CoastRunnerCNC/coastrunner_cr1_pcbs/cr1_led_board/README.md

# CR1 LED Strip
LED PCB for CR-1. Also contains mount for probe wire plug.

PCB designed in KiCAD.
