CoastRunnerCNC/coastrunner_cr1_pcbs/cr1_uno_shield/README.md

# Coast Runner Uno Shield
Uno Shield for CR-1: closed loop spindle VFD + 4 stepper drivers
Main Controller PCB for CR-1.  Hardware version 3B

This is the first PCB shipped in CR-1.

PCB designed in KiCAD.
