CoastRunnerCNC/coastrunner_cr1_pcbs/cr1_led_board/PCB/LEDIO.kicad_pcb

## KiCad design cr1_led_board/PCB/LEDIO.kicad_pcb (2024-05-17)

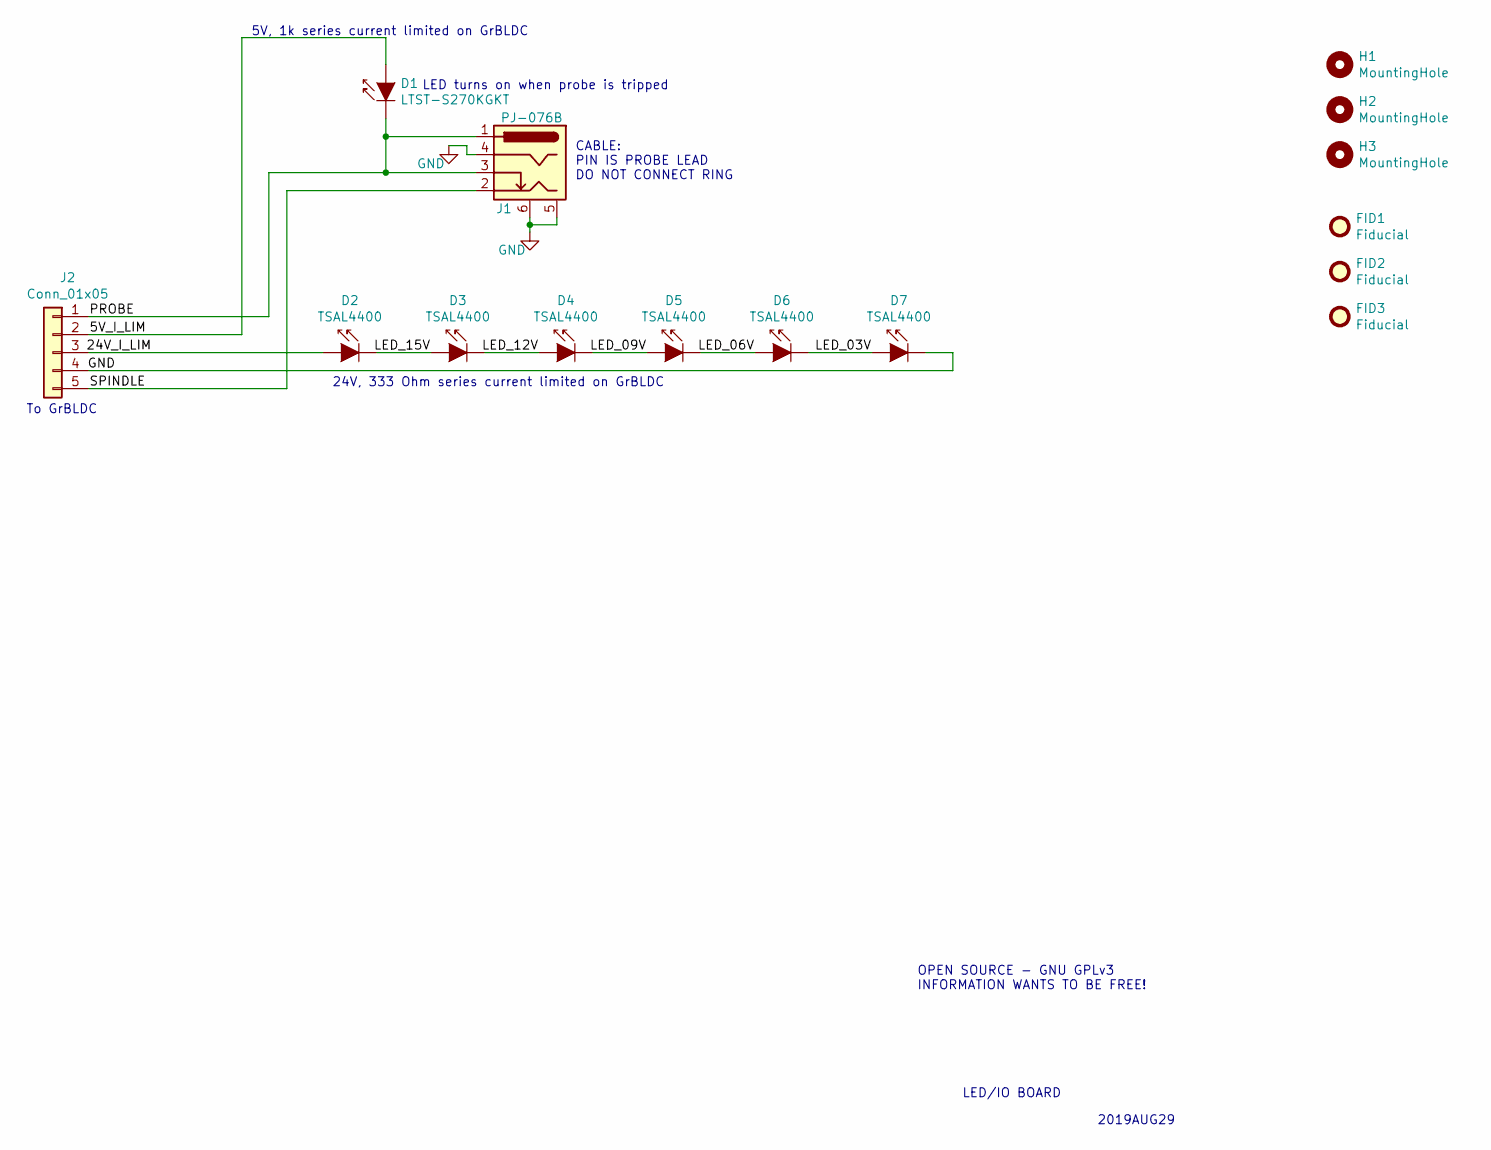
[picture p1: schematic LEDIO.sch]

Parts:
D1: LTST-S270KGKT; D_0603_1608Metric
D2, D3, D4, D5, D6, D7: TSAL4400; D_1206_3216Metric
FID1, FID2, FID3: Fiducial; Fiducial_0.5mm_Mask1mm
H1, H2, H3: MountingHole; MountingHole_3.2mm_M3
J1: PJ-076B; CUI_PJ-076
J2: Conn_01x05; PinHeader_1x05_P2.54mm_Horizontal

Connections:
/5V_I_LIM: D1.2 (A), J2.2
/24V_I_LIM: D2.2 (A), J2.3
/LED_03V: D6.1 (K), D7.2 (A)
/LED_06V: D5.1 (K), D6.2 (A)
/LED_09V: D4.1 (K), D5.2 (A)
/LED_12V: D3.1 (K), D4.2 (A)
/LED_15V: D2.1 (K), D3.2 (A)
/PROBE: D1.1 (K), J1.1, J1.3, J2.1
/SPINDLE: J1.2, J2.5
GND: D7.1 (K), J1.4, J1.5 (ShieldA), J1.6 (ShieldB), J2.4

Notes on the sheet:
CABLE: PIN IS PROBE LEAD DO NOT CONNECT RING
2019AUG29
LED/IO BOARD
OPEN SOURCE - GNU GPLv3 INFORMATION WANTS TO BE FREE!
5V, 1k series current limited on GrBLDC
To GrBLDC
LED turns on when probe is tripped
24V, 333 Ohm series current limited on GrBLDC

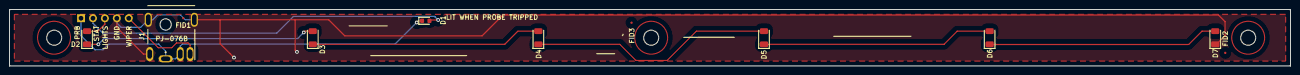
[picture p2: board LEDIO.kicad_pcb from above]

Board: 2 copper layers, 272.5 x 12.0 mm, 15 parts (1 on the bottom side), 10 nets.
