CoastRunnerCNC/coastrunner_cr1_pcbs/cr1_uno_shield/PCB (KiCAD)/GrBLDC.kicad_pcb

## KiCad design cr1_uno_shield/PCB (KiCAD)/GrBLDC.kicad_pcb (2024-05-17)

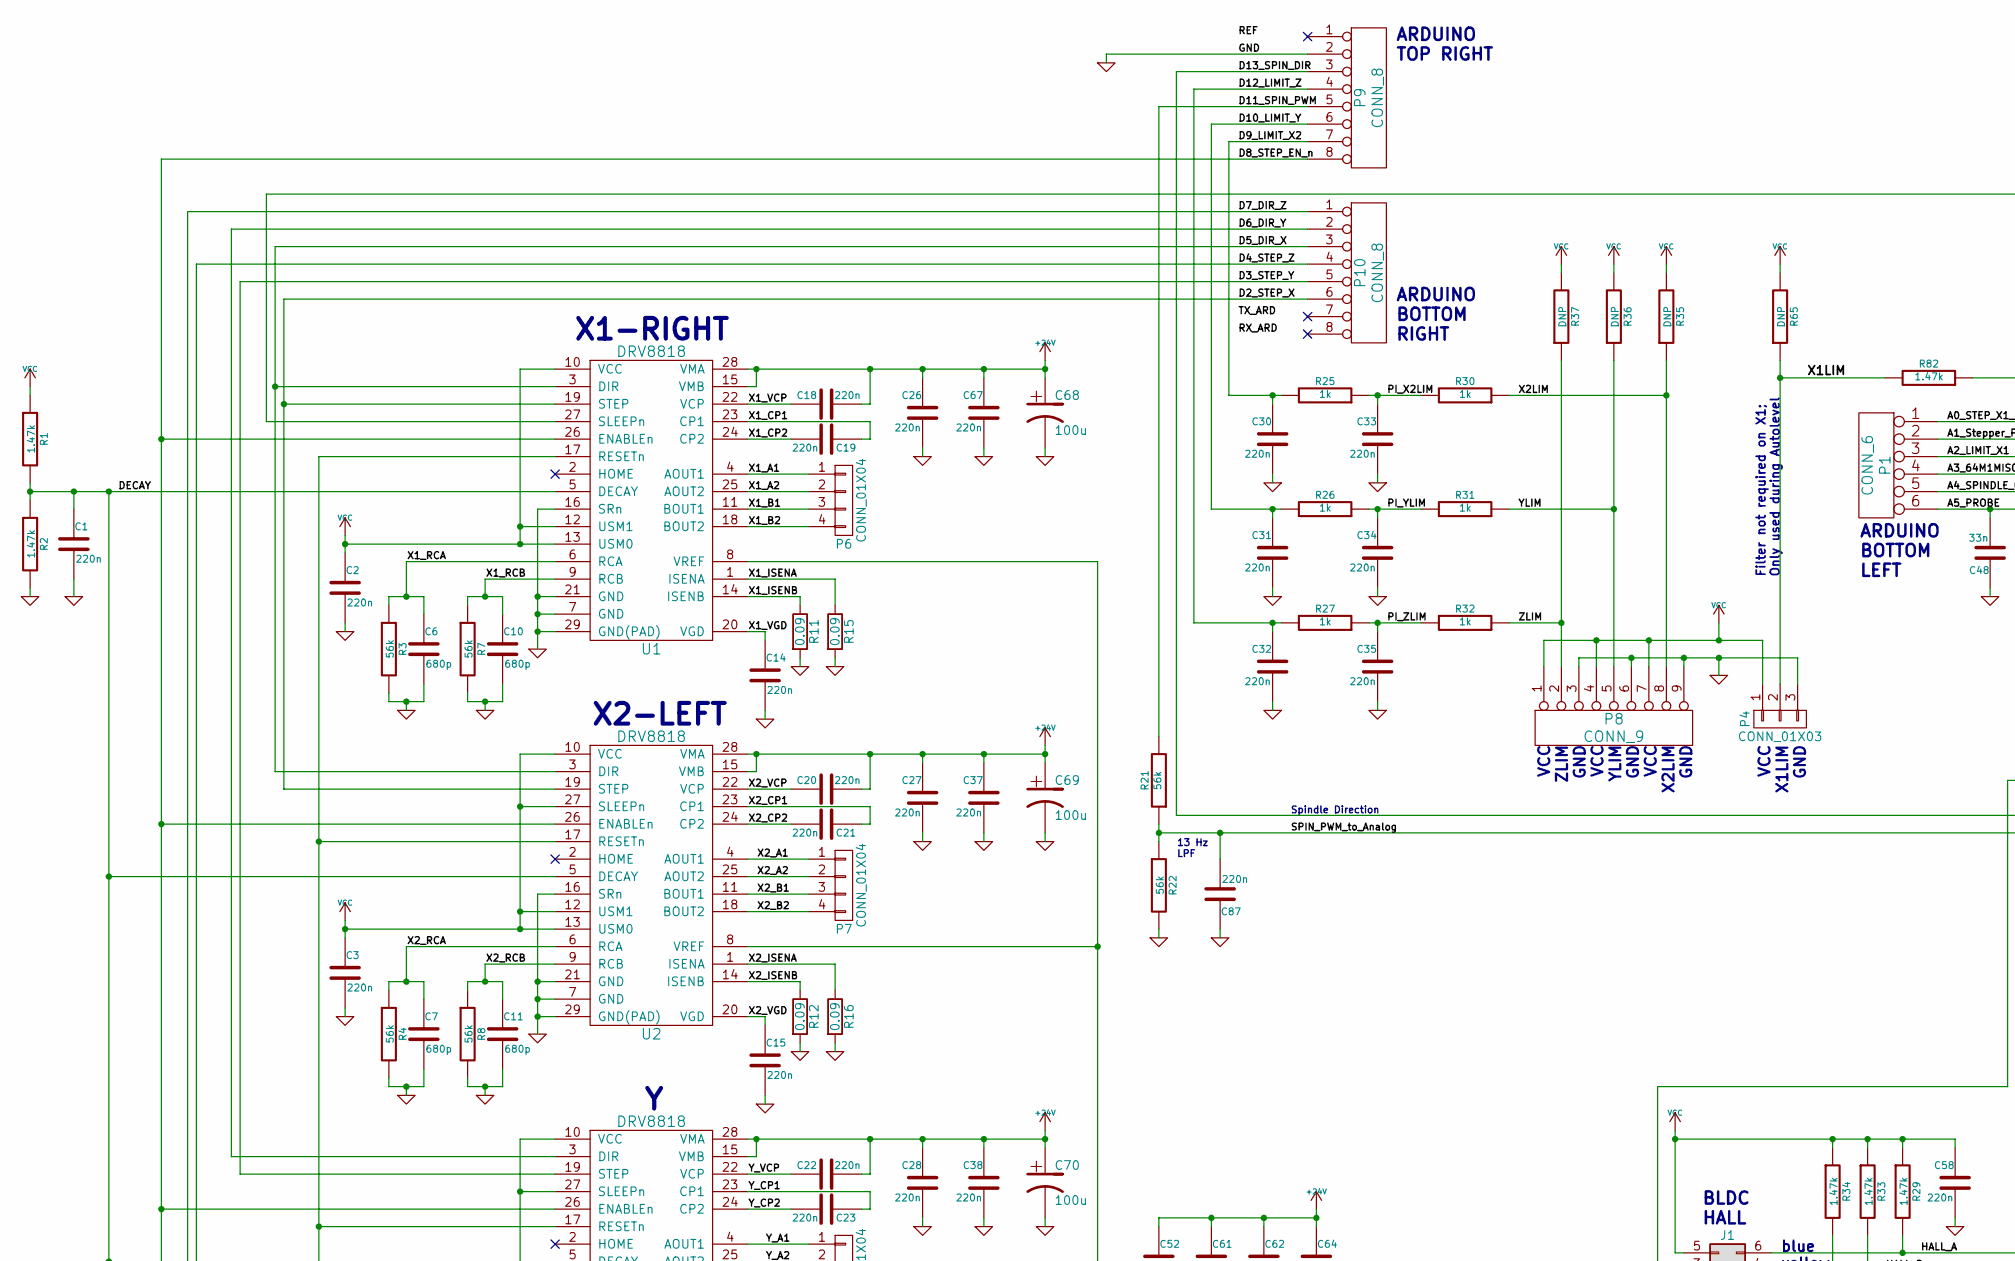
[picture p3: schematic GrBLDC.sch, GrBLDCv3 - CNC Stepper & BLDC Arduino Shield, part in row 1, column 1]

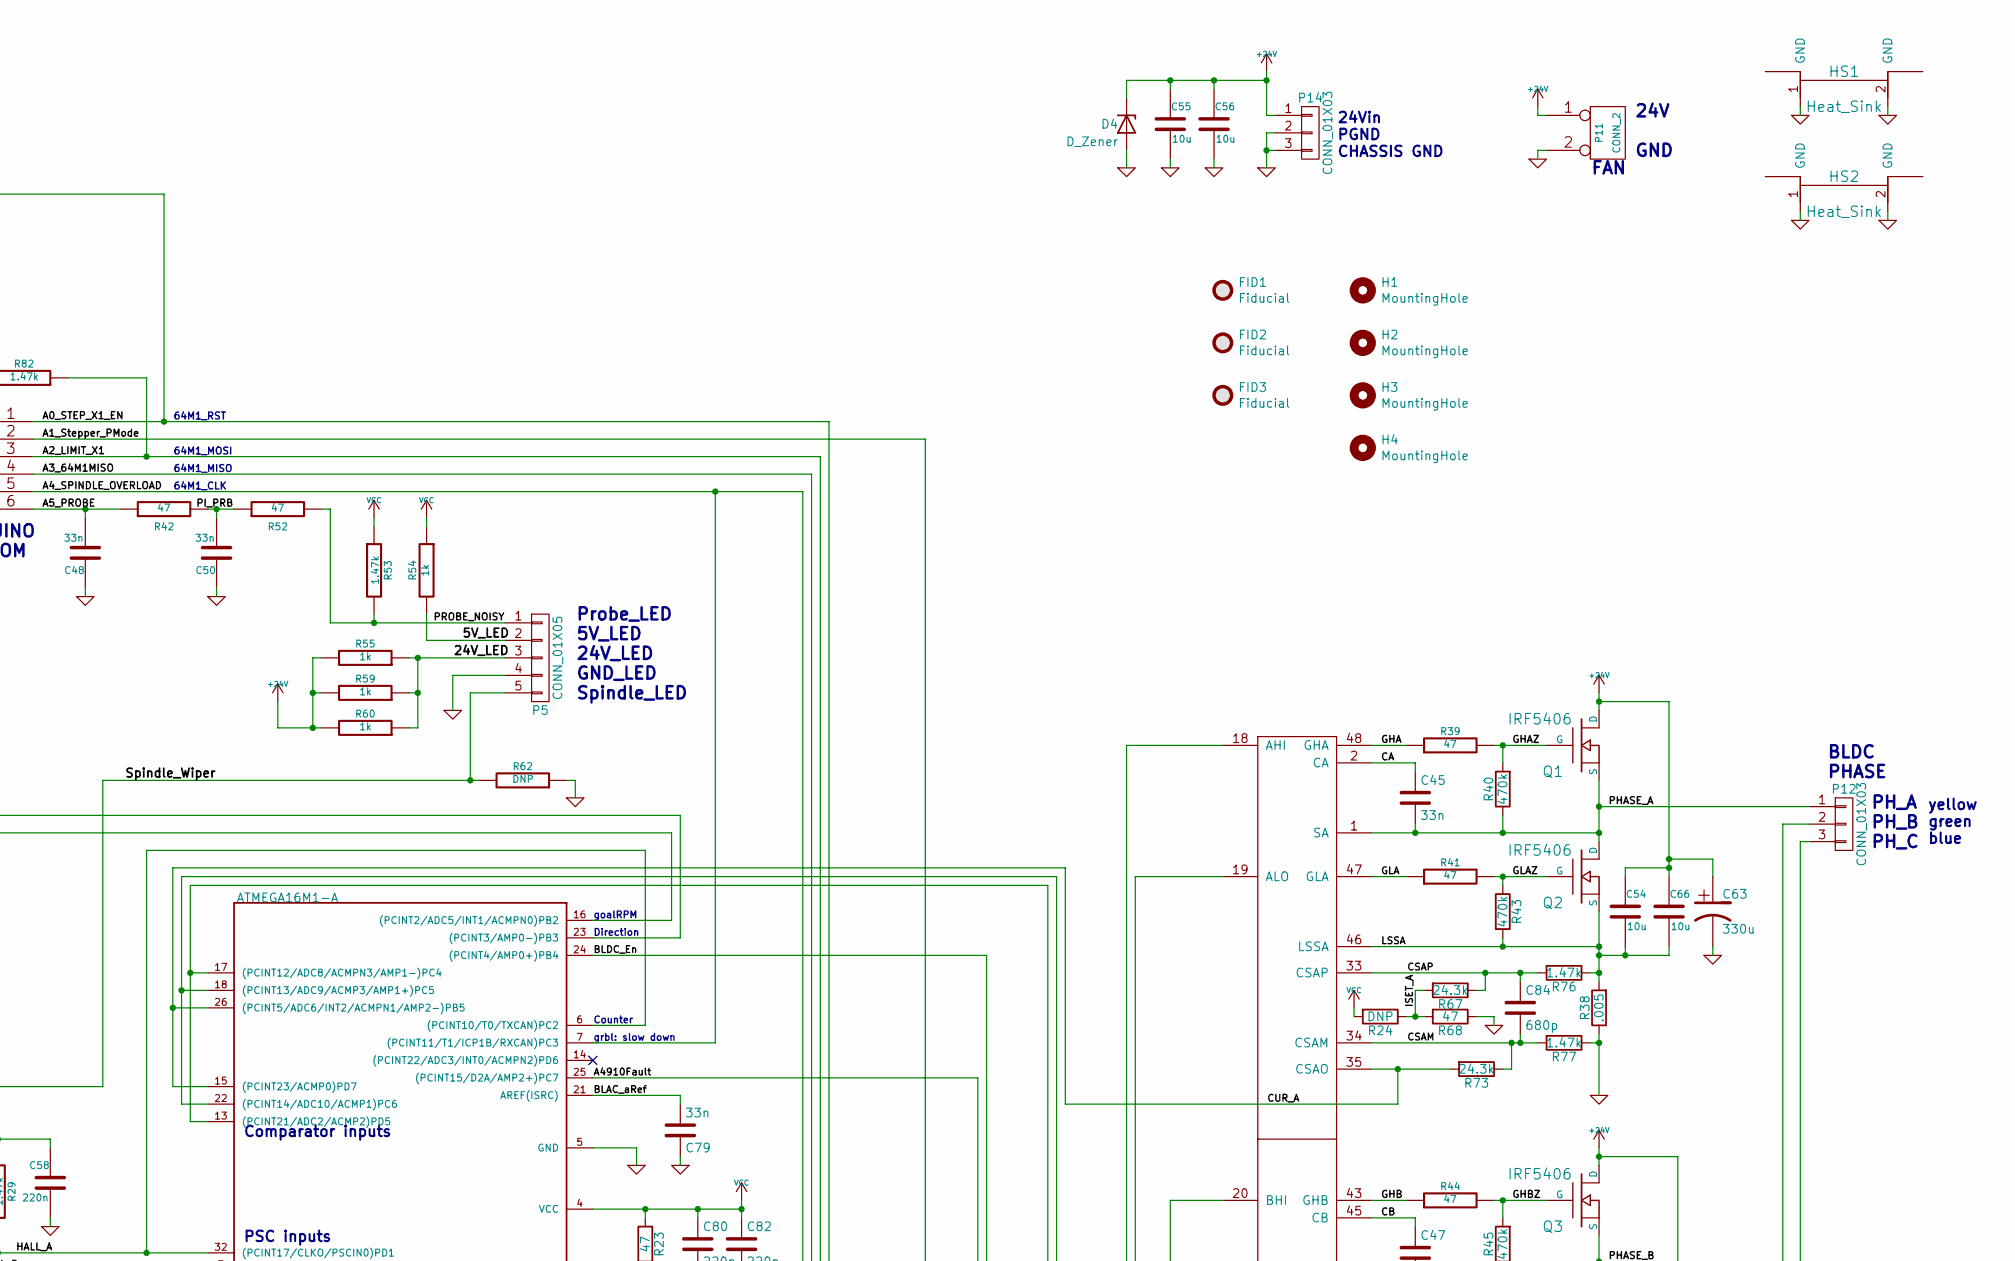
[picture p4: schematic GrBLDC.sch, GrBLDCv3 - CNC Stepper & BLDC Arduino Shield, part in row 1, column 2]

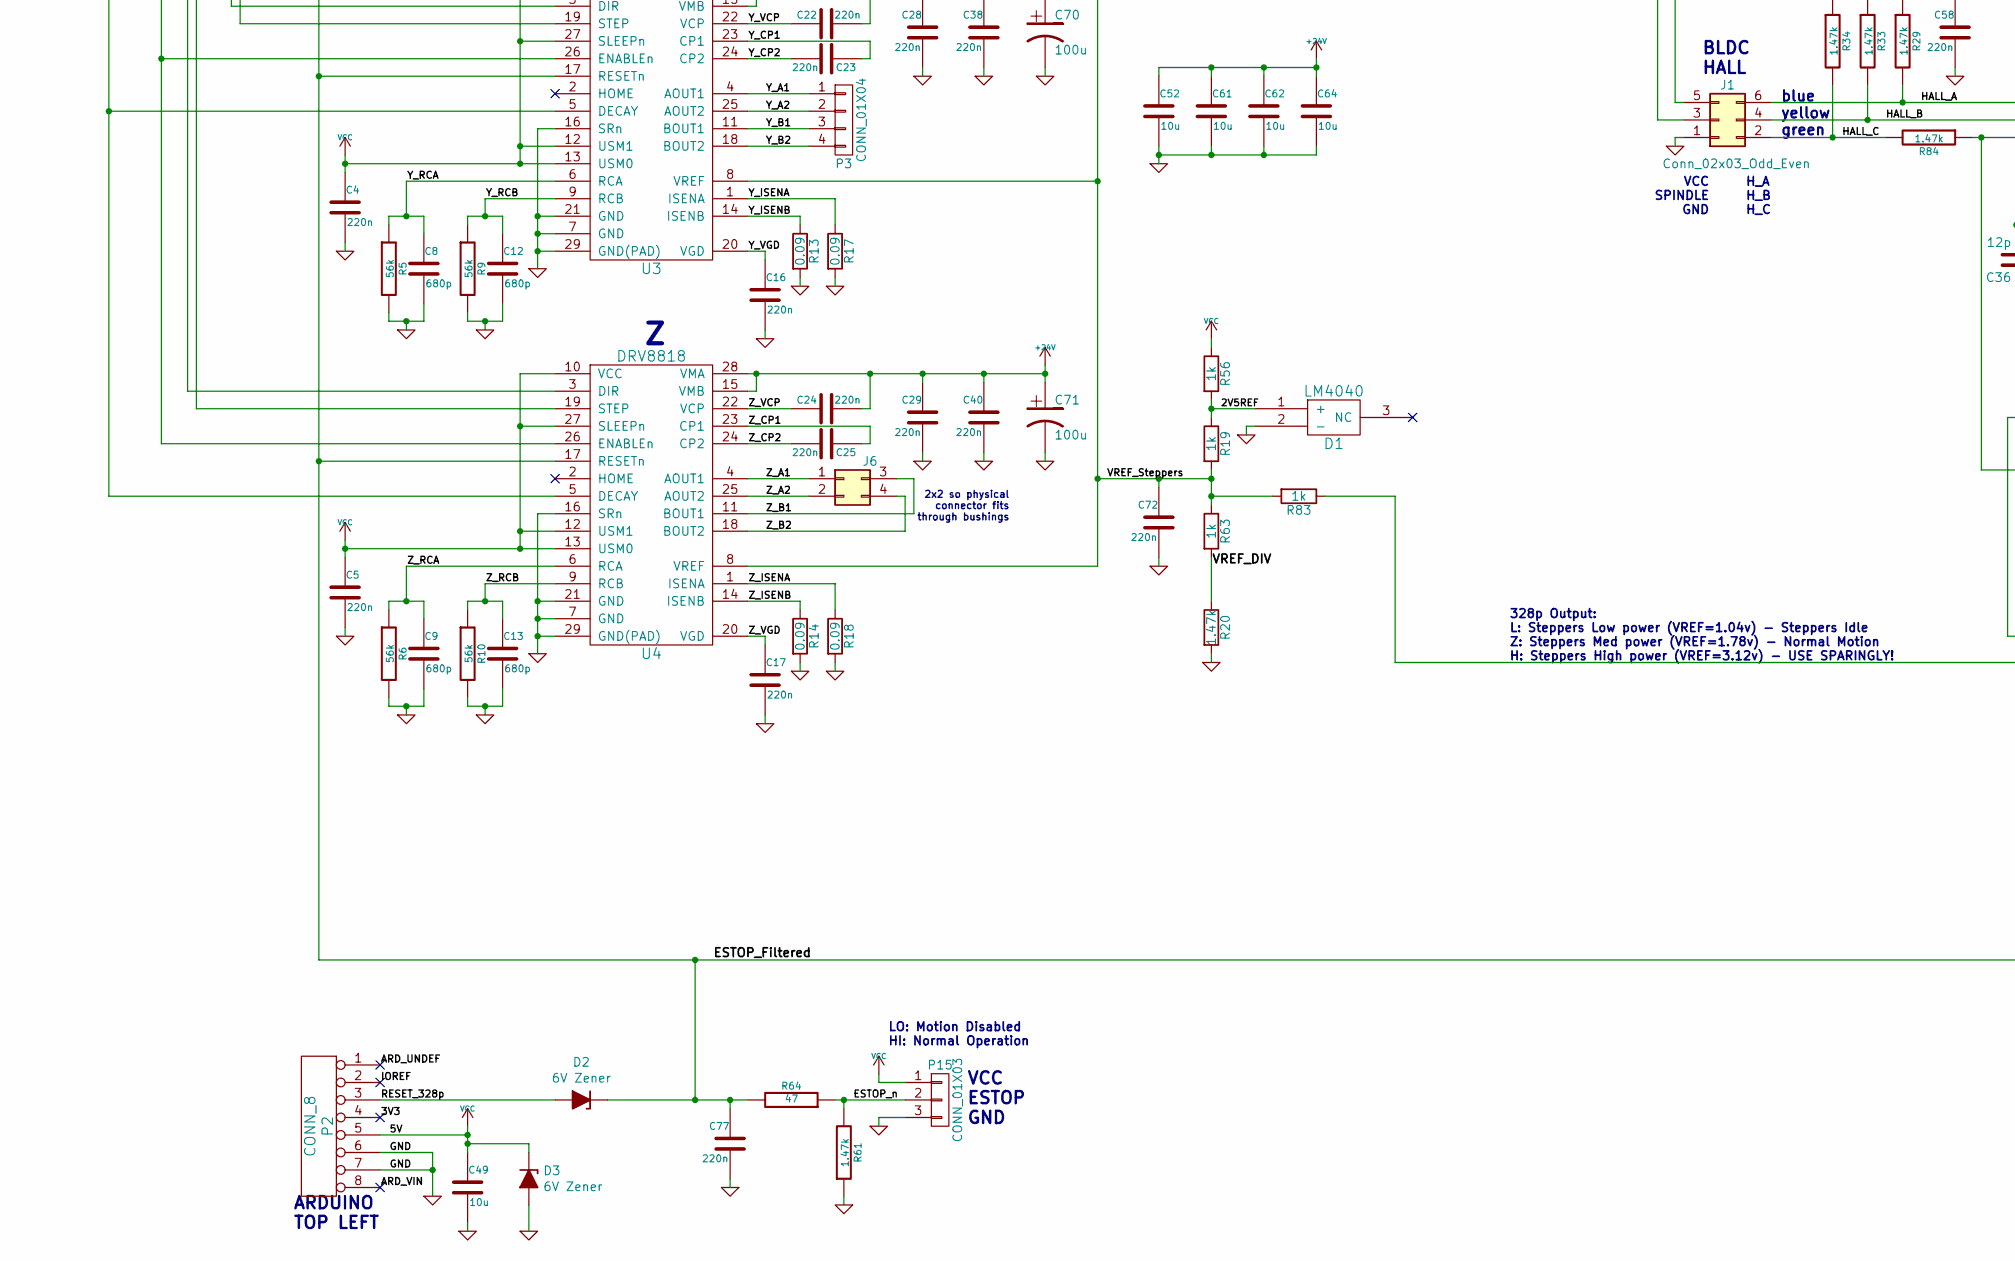
[picture p5: schematic GrBLDC.sch, GrBLDCv3 - CNC Stepper & BLDC Arduino Shield, part in row 2, column 1]

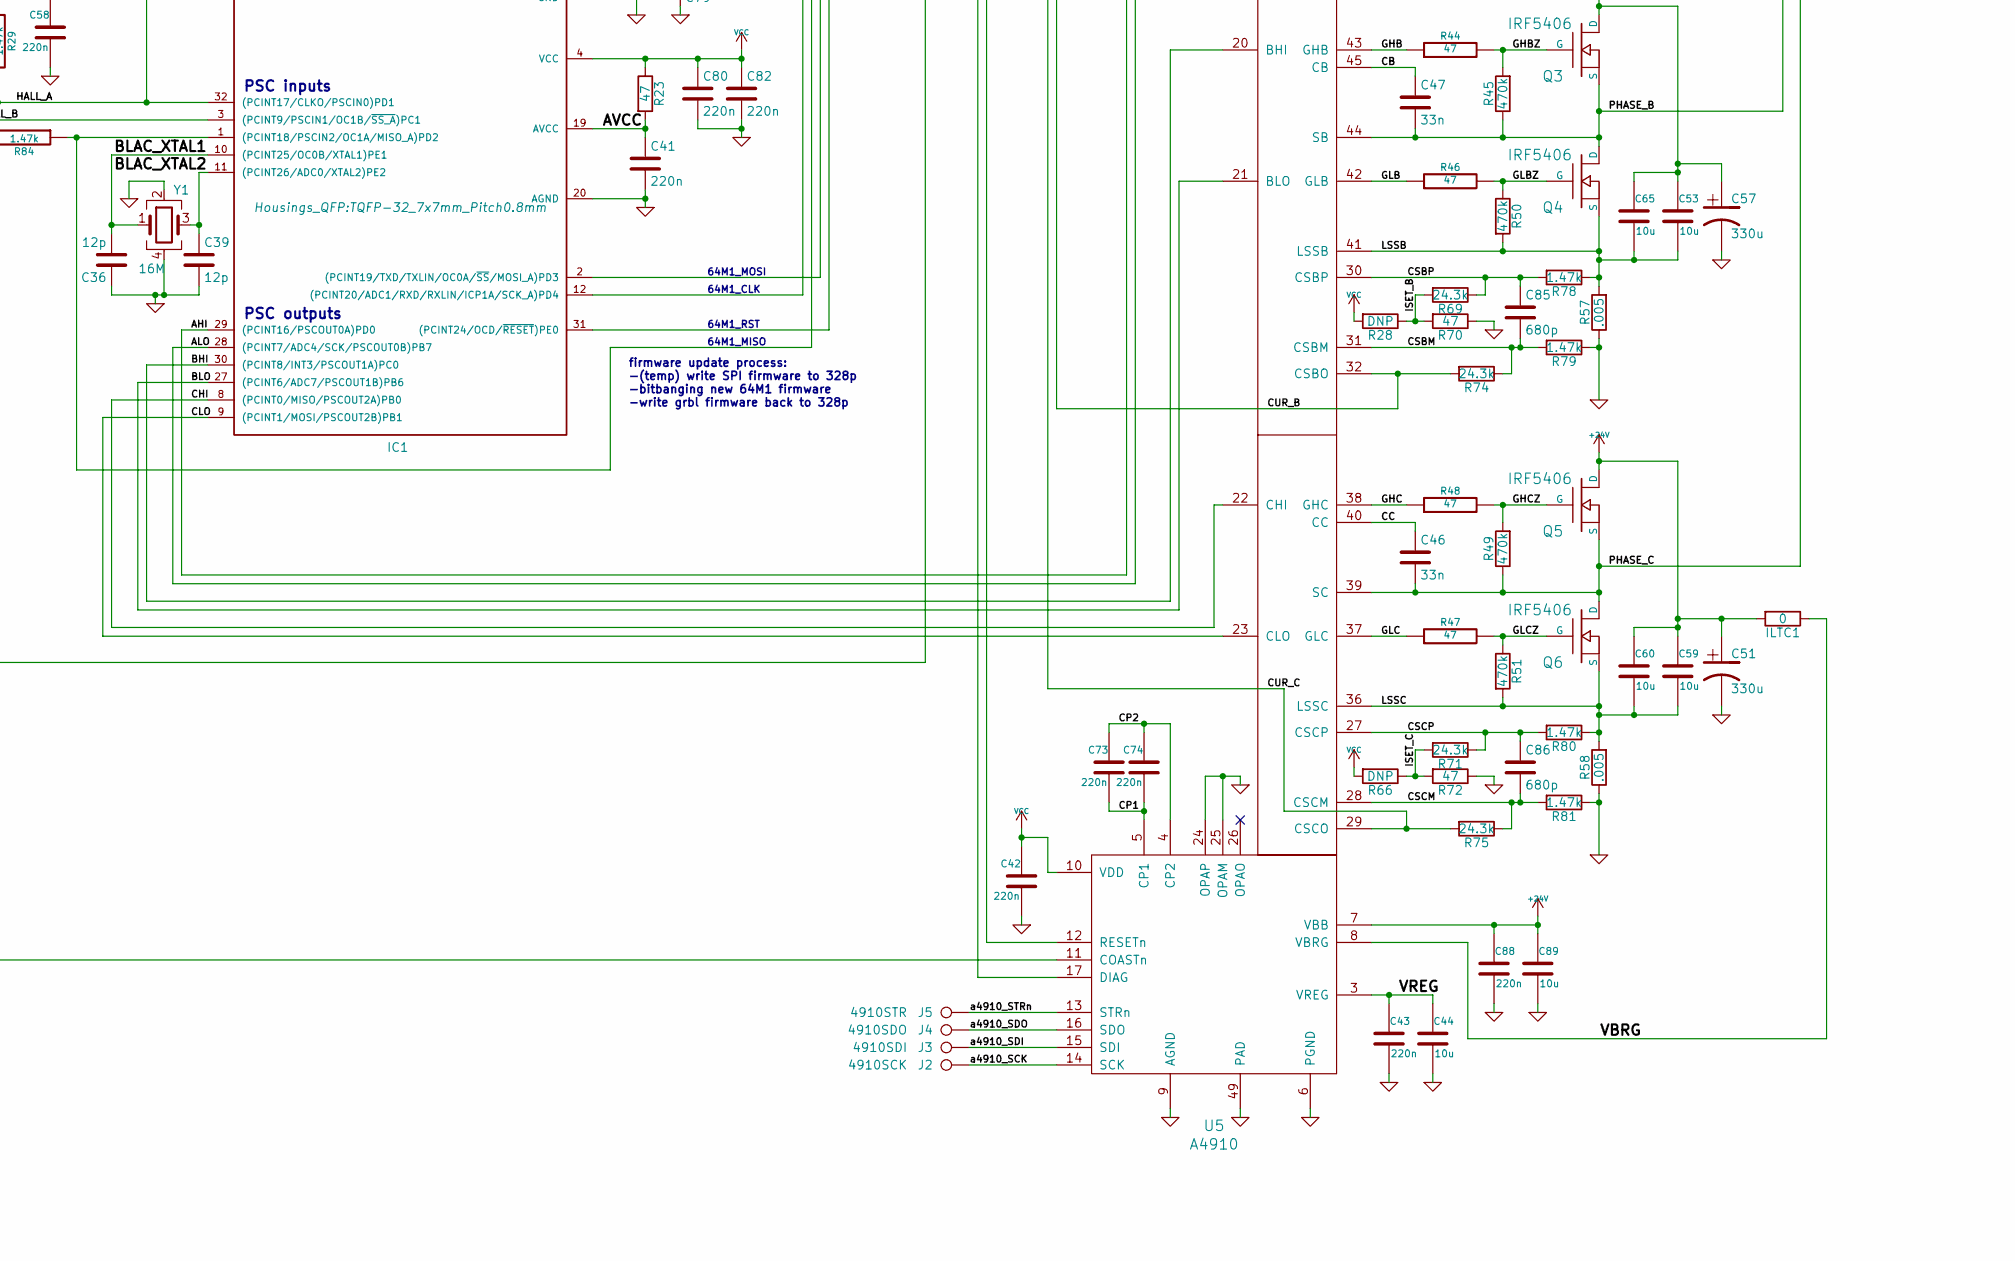
[picture p6: schematic GrBLDC.sch, GrBLDCv3 - CNC Stepper & BLDC Arduino Shield, part in row 2, column 2]

Parts:
C1, C2, C3, C4, C5, C14, C15, C16, C17, C18, C19, C20, C21, C22, C23, C24, C25, C26, C27, C28, C29, C30, C31, C32, C33, C34, C35, C37, C38, C40, C41, C42, C43, C58, C67, C72, C73, C74, C77, C80, C82, C87, C88: 220n; C_0603
C6, C7, C8, C9, C10, C11, C12, C13, C84, C85, C86: 680p; C_0603
C36, C39: 12p; C_0603
C44, C49, C52, C53, C54, C55, C56, C59, C60, C61, C62, C64, C65, C66, C89: 10u; C_1206
C45, C46, C47, C48, C50, C79: 33n; C_0603
C51, C57, C63: 330u; c_elec_10x10.5
C68, C69, C70, C71: 100u; c_elec_493-3953-2-ND_6.3x7.7
D1: LM4040; SOT-23
D2, D3: 6V Zener; D_SOD-123
D4: D_Zener; D_SMB
FID1, FID2, FID3: Fiducial; Fiducial_1.5mm_Mask3mm
H1, H2, H3, H4: MountingHole; MountingHole_2mm
HS1, HS2: Heat_Sink; HeatSink
IC1: ATMEGA16M1-A; TQFP-32_7x7mm_Pitch0.8mm
ILTC1: 0; ILTC
J1: Conn_02x03_Odd_Even; PinHeader_2x03_P2.54mm_Vertical
J2: 4910SCK; TestPoint_Pad_D1.0mm
J3: 4910SDI; TestPoint_Pad_D1.0mm
J4: 4910SDO; TestPoint_Pad_D1.0mm
J5: 4910STR; TestPoint_Pad_1.0x1.0mm
J6: Conn_02x02_Top_Bottom; PinHeader_2x02_P2.54mm_Vertical
P1: CONN_6; PinHeader_1x06_P2.54mm_Vertical
P2, P9, P10: CONN_8; PinHeader_1x08_P2.54mm_Vertical
P3, P6, P7: CONN_01X04; Pin_A98335-ND_1x04
P4: CONN_01X03; PinHeader_1x03_P2.54mm_Vertical
P5: CONN_01X05; PinHeader_1x05_P2.54mm_Vertical
P8: CONN_9; PinHeader_1x09_P2.54mm_Vertical
P11: CONN_2; PinHeader_1x02_P2.54mm_Vertical
P12: CONN_01X03; 277-1722-ND
P14: CONN_01X03; Pin_Header_277-1578-ND_3x01
P15: CONN_01X03; Socket_Strip_Straight_1x03
Q1, Q2, Q3, Q4, Q5, Q6: IRF5406
R1, R2, R20, R29, R33, R34, R53, R61, R76, R77, R78, R79, R80, R81: 1.47k; R_0603
R3, R4, R5, R6, R7, R8, R9, R10, R21, R22: 56k; R_0603
R11, R12, R13, R14, R15, R16, R17, R18: 0.09; R_1206
R19, R25, R26, R27, R30, R31, R32: 1k; R_0603
R23, R39, R41, R42, R44, R46, R47, R48, R52, R64, R68, R70, R72: 47; R_0603
R24, R28, R35, R36, R37, R66: DNP; R_0603
R38, R57, R58: .005; R_1206
R40, R43, R45, R49, R50, R51: 470k; R_0603
R54, R55, R56, R59, R60, R63, R83: 1k; R_0603_1608Metric
R62, R65: DNP; R_0603_1608Metric
R67, R69, R71, R73, R74, R75: 24.3k; R_0603
R82, R84: 1.47k; R_0603_1608Metric
U1, U2, U3, U4: DRV8818
U5: A4910; A4910-LQFP_48
Y1: 16M; Crystal_SMD_2016-4pin_2.0x1.6mm

Connections:
+24V: C18.2, C20.2, C22.2, C24.2, C26.1, C27.1, C28.1, C29.1, C37.1, C38.1, C40.1, C51.1, C52.1, C53.1, C54.1, C55.1, C56.1, C57.1, C59.1, C60.1, C61.1, C62.1, C63.1, C64.1, C65.1, C66.1, C67.1, C68.1, C69.1, C70.1, C71.1, C88.1, C89.1, D4.1 (K), ILTC1.2, P11.1, P14.1, Q1.D, Q3.D, Q5.D, R55.2, R59.2, R60.2, U1.15 (VMB), U1.28 (VMA), U2.15 (VMB), U2.28 (VMA), U3.15 (VMB), U3.28 (VMA), U4.15 (VMB), U4.28 (VMA), U5.7 (VBB)
/2V5REF: D1.1 (+), R19.1, R56.2
/3V3: P2.4
/5V_LED: P5.2, R54.2
/24V_LED: P5.3, R55.1, R59.1, R60.1
/A0_STEP_X1_EN: IC1.31 ((PCINT24/OCD/~RESET~)PE0), P1.1, U1.27 (SLEEPn)
/A1_Stepper_PMode: P1.2, R83.1
/A2_LIMIT_X1: IC1.2 ((PCINT19/TXD/TXLIN/OC0A/~SS~/MOSI_A)PD3), P1.3, R82.1
/A3_64M1MISO: IC1.1 ((PCINT18/PSCIN2/OC1A/MISO_A)PD2), P1.4, R84.1
/A4_SPINDLE_OVERLOAD: IC1.7 ((PCINT11/T1/ICP1B/RXCAN)PC3), IC1.12 ((PCINT20/ADC1/RXD/RXLIN/ICP1A/SCK_A)PD4), P1.5
/A5_PROBE: C48.2, P1.6, R42.1
/A4910Fault: IC1.25 ((PCINT15/D2A/AMP2+)PC7), U5.17 (DIAG)
/AHI: IC1.29 ((PCINT16/PSCOUT0A)PD0), U5.18 (AHI)
/ALO: IC1.28 ((PCINT7/ADC4/SCK/PSCOUT0B)PB7), U5.19 (ALO)
/ARD_UNDEF: P2.1
/ARD_VIN: P2.8
/AVCC: C41.1, IC1.19 (AVCC), R23.2
/BHI: IC1.30 ((PCINT8/INT3/PSCOUT1A)PC0), U5.20 (BHI)
/BLAC_XTAL1: C36.2, IC1.10 ((PCINT25/OC0B/XTAL1)PE1), Y1.1
/BLAC_XTAL2: C39.1, IC1.11 ((PCINT26/ADC0/XTAL2)PE2), Y1.3
/BLAC_aRef: C79.2, IC1.21 (AREF(ISRC))
/BLDC_En: IC1.24 ((PCINT4/AMP0+)PB4), U5.12 (RESETn)
/BLO: IC1.27 ((PCINT6/ADC7/PSCOUT1B)PB6), U5.21 (BLO)
/CA: C45.1, U5.2 (CA)
/CB: C47.1, U5.45 (CB)
/CC: C46.1, U5.40 (CC)
/CHI: IC1.8 ((PCINT0/MISO/PSCOUT2A)PB0), U5.22 (CHI)
/CLO: IC1.9 ((PCINT1/MOSI/PSCOUT2B)PB1), U5.23 (CLO)
/CP1: C73.2, C74.2, U5.5 (CP1)
/CP2: C73.1, C74.1, U5.4 (CP2)
/CSAM: C84.2, R73.1, R77.2, U5.34 (CSAM)
/CSAP: C84.1, R67.1, R76.2, U5.33 (CSAP)
/CSBM: C85.2, R74.1, R79.2, U5.31 (CSBM)
/CSBP: C85.1, R69.1, R78.2, U5.30 (CSBP)
/CSCM: C86.2, R75.1, R81.2, U5.28 (CSCM)
/CSCP: C86.1, R71.1, R80.2, U5.27 (CSCP)
/CUR_A: IC1.15 ((PCINT23/ACMP0)PD7), IC1.26 ((PCINT5/ADC6/INT2/ACMPN1/AMP2-)PB5), R73.2, U5.35 (CSAO)
/CUR_B: IC1.18 ((PCINT13/ADC9/ACMP3/AMP1+)PC5), IC1.22 ((PCINT14/ADC10/ACMP1)PC6), R74.2, U5.32 (CSBO)
/CUR_C: IC1.13 ((PCINT21/ADC2/ACMP2)PD5), IC1.17 ((PCINT12/ADC8/ACMPN3/AMP1-)PC4), R75.2, U5.29 (CSCO)
/D2_STEP_X: P10.6, U1.19 (STEP), U2.19 (STEP)
/D3_STEP_Y: P10.5, U3.19 (STEP)
/D4_STEP_Z: P10.4, U4.19 (STEP)
/D5_DIR_X: P10.3, U1.3 (DIR), U2.3 (DIR)
/D6_DIR_Y: P10.2, U3.3 (DIR)
/D7_DIR_Z: P10.1, U4.3 (DIR)
/D8_STEP_EN_n: P9.8, U1.26 (ENABLEn), U2.26 (ENABLEn), U3.26 (ENABLEn), U4.26 (ENABLEn)
/D9_LIMIT_X2: C30.1, P9.7, R25.2
/D10_LIMIT_Y: C31.1, P9.6, R26.2
/D11_SPIN_PWM: P9.5, R21.2
/D12_LIMIT_Z: C32.1, P9.4, R27.2
/D13_SPIN_DIR: IC1.23 ((PCINT3/AMP0-)PB3), P9.3
/DECAY: C1.1, R1.2, R2.1, U1.5 (DECAY), U2.5 (DECAY), U3.5 (DECAY), U4.5 (DECAY)
/ESTOP_Filtered: C77.1, D2.1 (K), R64.2, U1.17 (RESETn), U2.17 (RESETn), U3.17 (RESETn), U4.17 (RESETn), U5.11 (COASTn)
/ESTOP_n: P15.2, R61.2, R64.1
/GHA: R39.1, U5.48 (GHA)
/GHAZ: Q1.G, R39.2, R40.2
/GHB: R44.1, U5.43 (GHB)
/GHBZ: Q3.G, R44.2, R45.2
/GHC: R48.1, U5.38 (GHC)
/GHCZ: Q5.G, R48.2, R49.2
/GLA: R41.1, U5.47 (GLA)
/GLAZ: Q2.G, R41.2, R43.1
/GLB: R46.1, U5.42 (GLB)
/GLBZ: Q4.G, R46.2, R50.1
/GLC: R47.1, U5.37 (GLC)
/GLCZ: Q6.G, R47.2, R51.1
/HALL_A: IC1.6 ((PCINT10/T0/TXCAN)PC2), IC1.32 ((PCINT17/CLKO/PSCIN0)PD1), J1.6, R29.2
/HALL_B: IC1.3 ((PCINT9/PSCIN1/OC1B/~SS_A~)PC1), J1.4, R33.2
/HALL_C: J1.2, R34.2, R84.2
/IOREF: P2.2
/ISET_A: R24.1, R67.2, R68.2
/ISET_B: R28.1, R69.2, R70.2
/ISET_C: R66.1, R71.2, R72.2
/LSSA: C54.2, C66.2, Q2.S, R38.2, R43.2, R76.1, U5.46 (LSSA)
/LSSB: C53.2, C65.2, Q4.S, R50.2, R57.2, R78.1, U5.41 (LSSB)
/LSSC: C59.2, C60.2, Q6.S, R51.2, R58.2, R80.1, U5.36 (LSSC)
/PHASE_A: C45.2, P12.1, Q1.S, Q2.D, R40.1, U5.1 (SA)
/PHASE_B: C47.2, P12.2, Q3.S, Q4.D, R45.1, U5.44 (SB)
/PHASE_C: C46.2, P12.3, Q5.S, Q6.D, R49.1, U5.39 (SC)
/PI_PRB: C50.2, R42.2, R52.1
/PI_X2LIM: C33.1, R25.1, R30.2
/PI_YLIM: C34.1, R26.1, R31.2
/PI_ZLIM: C35.1, R27.1, R32.2
/PROBE_NOISY: P5.1, R52.2, R53.2
/RESET_328p: D2.2 (A), P2.3
/SPIN_PWM_to_Analog: C87.2, IC1.16 ((PCINT2/ADC5/INT1/ACMPN0)PB2), R21.1, R22.1
/Spindle_Wiper: J1.3, P5.5, R62.2
/VBRG: ILTC1.1, U5.8 (VBRG)
/VREF_DIV: R20.1, R63.2
/VREF_Steppers: C72.1, R19.2, R63.1, R83.2, U1.8 (VREF), U2.8 (VREF), U3.8 (VREF), U4.8 (VREF)
/VREG: C43.1, C44.1, U5.3 (VREG)
/X1LIM: P4.2, R65.1, R82.2
/X1_A1: P6.1, U1.4 (AOUT1)
/X1_A2: P6.2, U1.25 (AOUT2)
/X1_B1: P6.3, U1.11 (BOUT1)
/X1_B2: P6.4, U1.18 (BOUT2)
/X1_CP1: C19.1, U1.23 (CP1)
/X1_CP2: C19.2, U1.24 (CP2)
/X1_ISENA: R15.1, U1.1 (ISENA)
/X1_ISENB: R11.1, U1.14 (ISENB)
/X1_RCA: C6.1, R3.1, U1.6 (RCA)
/X1_RCB: C10.1, R7.1, U1.9 (RCB)
/X1_VCP: C18.1, U1.22 (VCP)
/X1_VGD: C14.1, U1.20 (VGD)
/X2LIM: P8.8, R30.1, R35.1
/X2_A1: P7.1, U2.4 (AOUT1)
/X2_A2: P7.2, U2.25 (AOUT2)
/X2_B1: P7.3, U2.11 (BOUT1)
/X2_B2: P7.4, U2.18 (BOUT2)
/X2_CP1: C21.1, U2.23 (CP1)
/X2_CP2: C21.2, U2.24 (CP2)
/X2_ISENA: R16.1, U2.1 (ISENA)
/X2_ISENB: R12.1, U2.14 (ISENB)
/X2_RCA: C7.1, R4.1, U2.6 (RCA)
/X2_RCB: C11.1, R8.1, U2.9 (RCB)
/X2_VCP: C20.1, U2.22 (VCP)
/X2_VGD: C15.1, U2.20 (VGD)
/YLIM: P8.5, R31.1, R36.1
/Y_A1: P3.1, U3.4 (AOUT1)
/Y_A2: P3.2, U3.25 (AOUT2)
/Y_B1: P3.3, U3.11 (BOUT1)
/Y_B2: P3.4, U3.18 (BOUT2)
/Y_CP1: C23.1, U3.23 (CP1)
/Y_CP2: C23.2, U3.24 (CP2)
/Y_ISENA: R17.1, U3.1 (ISENA)
/Y_ISENB: R13.1, U3.14 (ISENB)
/Y_RCA: C8.1, R5.1, U3.6 (RCA)
/Y_RCB: C12.1, R9.1, U3.9 (RCB)
/Y_VCP: C22.1, U3.22 (VCP)
/Y_VGD: C16.1, U3.20 (VGD)
/ZLIM: P8.2, R32.1, R37.1
/Z_A1: J6.1, U4.4 (AOUT1)
/Z_A2: J6.2, U4.25 (AOUT2)
/Z_B1: J6.3, U4.11 (BOUT1)
/Z_B2: J6.4, U4.18 (BOUT2)
/Z_CP1: C25.1, U4.23 (CP1)
/Z_CP2: C25.2, U4.24 (CP2)
/Z_ISENA: R18.1, U4.1 (ISENA)
/Z_ISENB: R14.1, U4.14 (ISENB)
/Z_RCA: C9.1, R6.1, U4.6 (RCA)
/Z_RCB: C13.1, R10.1, U4.9 (RCB)
/Z_VCP: C24.1, U4.22 (VCP)
/Z_VGD: C17.1, U4.20 (VGD)
/a4910_SCK: J2.1, U5.14 (SCK)
/a4910_SDI: J3.1, U5.15 (SDI)
/a4910_SDO: J4.1, U5.16 (SDO)
/a4910_STRn: J5.1, U5.13 (STRn)
GND: C1.2, C2.2, C3.2, C4.2, C5.2, C6.2, C7.2, C8.2, C9.2, C10.2, C11.2, C12.2, C13.2, C14.2, C15.2, C16.2, C17.2, C26.2, C27.2, C28.2, C29.2, C30.2, C31.2, C32.2, C33.2, C34.2, C35.2, C36.1, C37.2, C38.2, C39.2, C40.2, C41.2, C42.2, C43.2, C44.2, C48.1, C49.2, C50.1, C51.2, C52.2, C55.2, C56.2, C57.2, C58.2, C61.2, C62.2, C63.2, C64.2, C67.2, C68.2, C69.2, C70.2, C71.2, C72.2, C77.2, C79.1, C80.2, C82.2, C87.1, C88.2, C89.2, D1.2 (-), D3.2 (A), D4.2 (A), HS1.1, HS1.2, HS2.1, HS2.2, IC1.5 (GND), IC1.20 (AGND), J1.1, P2.6, P2.7, P4.3, P5.4, P8.3, P8.6, P8.9, P9.2, P11.2 (PM), P14.2, P14.3, P15.3, R2.2, R3.2, R4.2, R5.2, R6.2, R7.2, R8.2, R9.2, R10.2, R11.2, R12.2, R13.2, R14.2, R15.2, R16.2, R17.2, R18.2, R20.2, R22.2, R38.1, R57.1, R58.1, R61.1, R62.1, R68.1, R70.1, R72.1, R77.1, R79.1, R81.1, U1.7 (GND), U1.16 (SRn), U1.21 (GND), U1.29 (GND(PAD)), U2.7 (GND), U2.16 (SRn), U2.21 (GND), U2.29 (GND(PAD)), U3.7 (GND), U3.16 (SRn), U3.21 (GND), U3.29 (GND(PAD)), U4.7 (GND), U4.16 (SRn), U4.21 (GND), U4.29 (GND(PAD)), U5.6 (PGND), U5.9 (AGND), U5.24 (OPAP), U5.25 (OPAM), U5.49 (PAD), Y1.2, Y1.4
VCC: C2.1, C3.1, C4.1, C5.1, C42.1, C49.1, C58.1, C80.1, C82.1, D3.1 (K), IC1.4 (VCC), J1.5, P2.5, P4.1, P8.1, P8.4, P8.7, P15.1, R1.1, R23.1, R24.2, R28.2, R29.1, R33.1, R34.1, R35.2, R36.2, R37.2, R53.1, R54.1, R56.1, R65.2, R66.2, U1.10 (VCC), U1.12 (USM1), U1.13 (USM0), U2.10 (VCC), U2.12 (USM1), U2.13 (USM0), U2.27 (SLEEPn), U3.10 (VCC), U3.12 (USM1), U3.13 (USM0), U3.27 (SLEEPn), U4.10 (VCC), U4.12 (USM1), U4.13 (USM0), U4.27 (SLEEPn), U5.10 (VDD)

Notes on the sheet:
VCC ZLIM GND VCC YLIM GND VCC X2LIM GND
ARDUINO BOTTOM RIGHT
ARDUINO TOP RIGHT
ARDUINO BOTTOM LEFT
FAN
PH_A PH_B PH_C
24V GND
BLDC PHASE
BLDC HALL
24Vin PGND CHASSIS GND
X1-RIGHT
X2-LEFT
blue yellow green
yellow green blue
VCC ESTOP GND
Comparator inputs
PSC inputs
PSC outputs
firmware update process: -(temp) write SPI firmware to 328p -bitbanging new 64M1 firmware -write grbl firmware back to 328p
Counter
13 Hz LPF
goalRPM
Spindle Direction
Direction
grbl: slow down
328p Output: L: Steppers Low power (VREF=1.04v) - Steppers Idle Z: Steppers Med power (VREF=1.78v) - Normal Motion H: Steppers High power (VREF=3.12v) - USE SPARINGLY!
Probe_LED 5V_LED 24V_LED GND_LED Spindle_LED
VCC SPINDLE GND
H_A H_B H_C
64M1_MOSI
64M1_CLK
2x2 so physical connector fits through bushings
64M1_MISO
64M1_RST
VCC X1LIM GND
Filter not required on X1; Only used during Autolevel
LO: Motion Disabled HI: Normal Operation
ARDUINO TOP LEFT

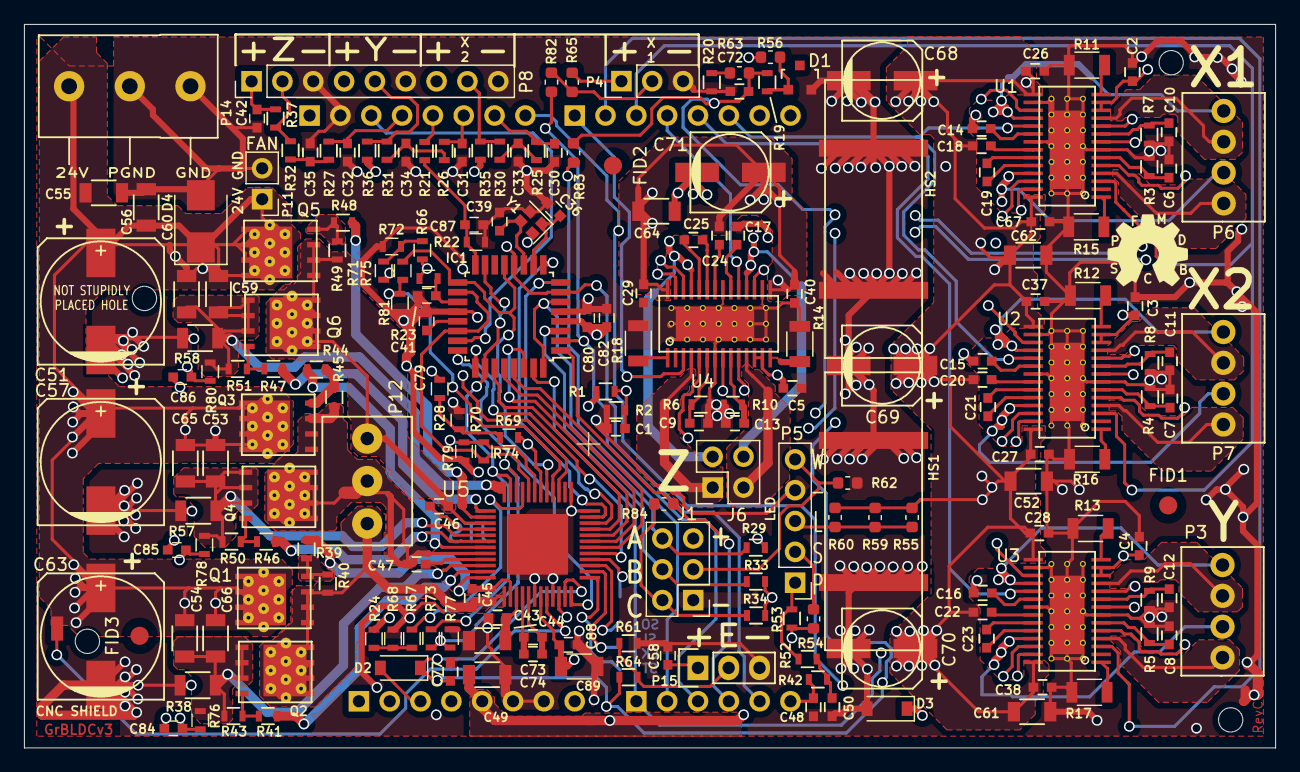
[picture p7: board GrBLDC.kicad_pcb from above]

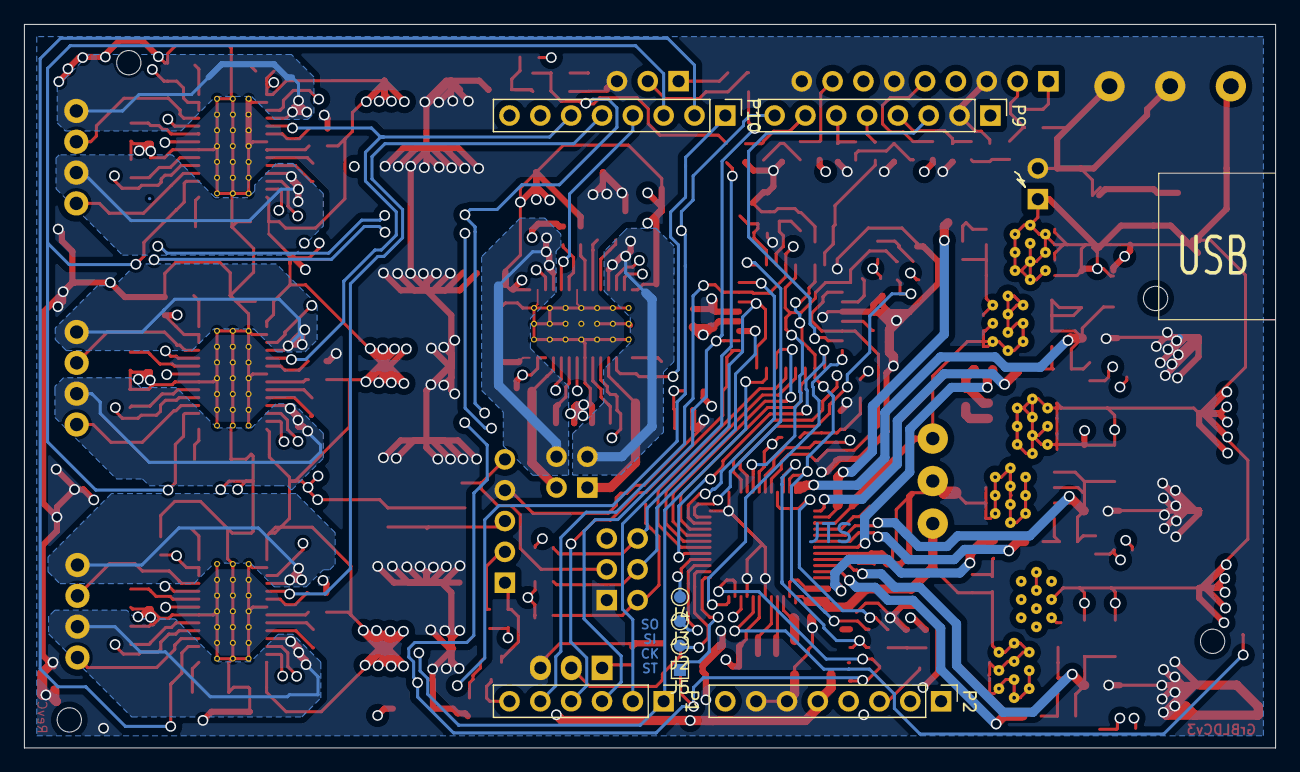
[picture p8: board GrBLDC.kicad_pcb from below]

Board: 6 copper layers, 103.1 x 59.6 mm, 215 parts (8 on the bottom side), 145 nets.
