CoastRunnerCNC/coastrunner_cr1_pcbs/(commit log)

2024-05-30 Adding Gerber files, BOM
    [Coast Runner_BOMs.csv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]
2024-05-30 Adding LED stuff to BOM
    [Coast Runner_BOMs.csv]
